fenofun/Powder-Trickler-Tank/images/Internal1.jpg

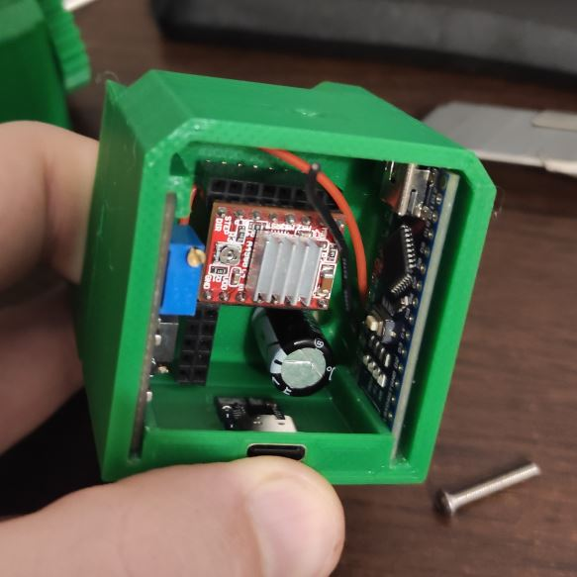
images/Internal1.jpg
