fenofun/Powder-Trickler-Tank/images/Driver1.jpg

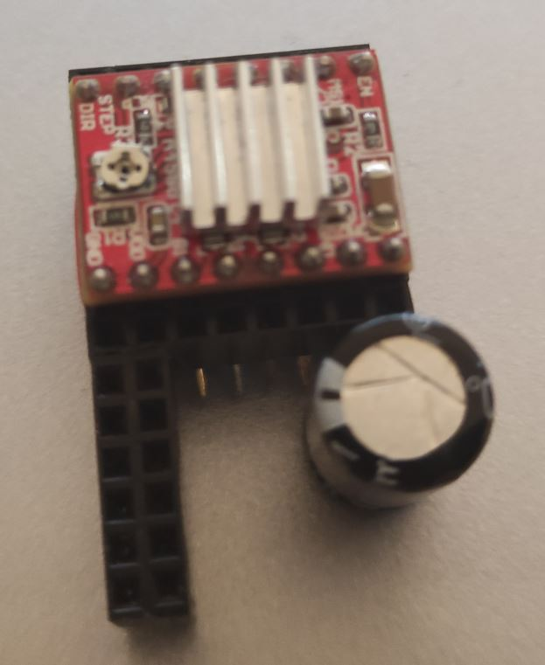
images/Driver1.jpg
