fenofun/Powder-Trickler-Tank/images/Driver2.jpg

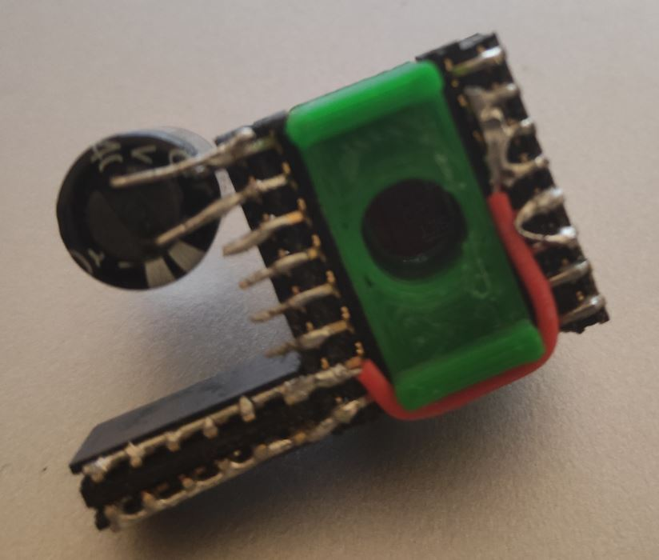
images/Driver2.jpg
