fenofun/Powder-Trickler-Tank/images/Internal2.jpg

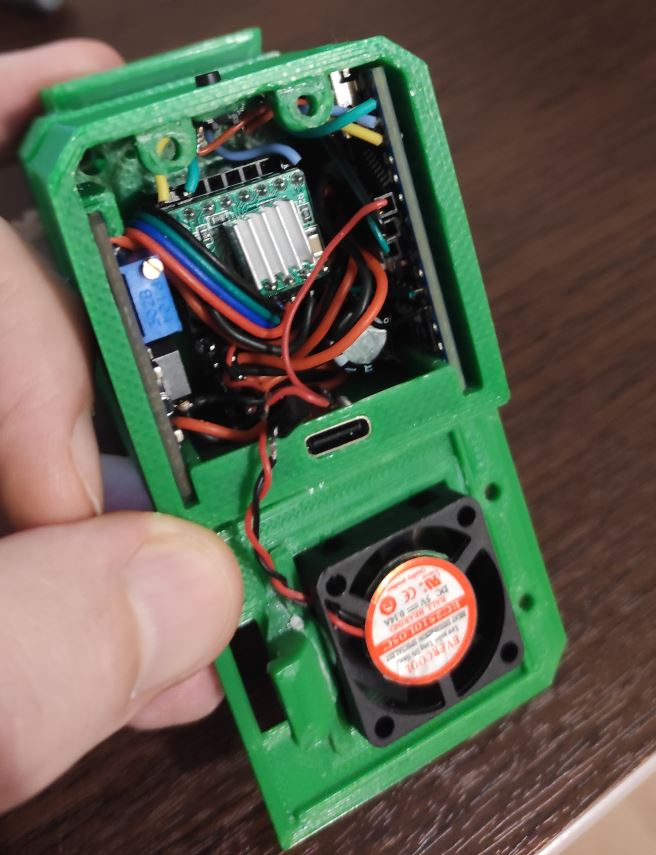
images/Internal2.jpg
