fenofun/Powder-Trickler-Tank/images/Scales.jpg

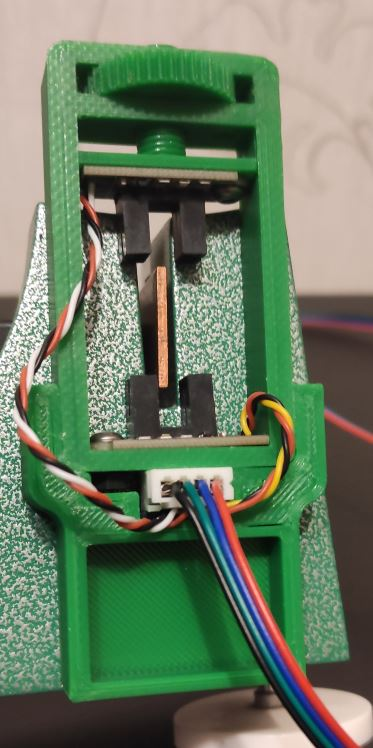
images/Scales.jpg
