fenofun/Powder-Trickler-Tank/images/TT_back.jpg

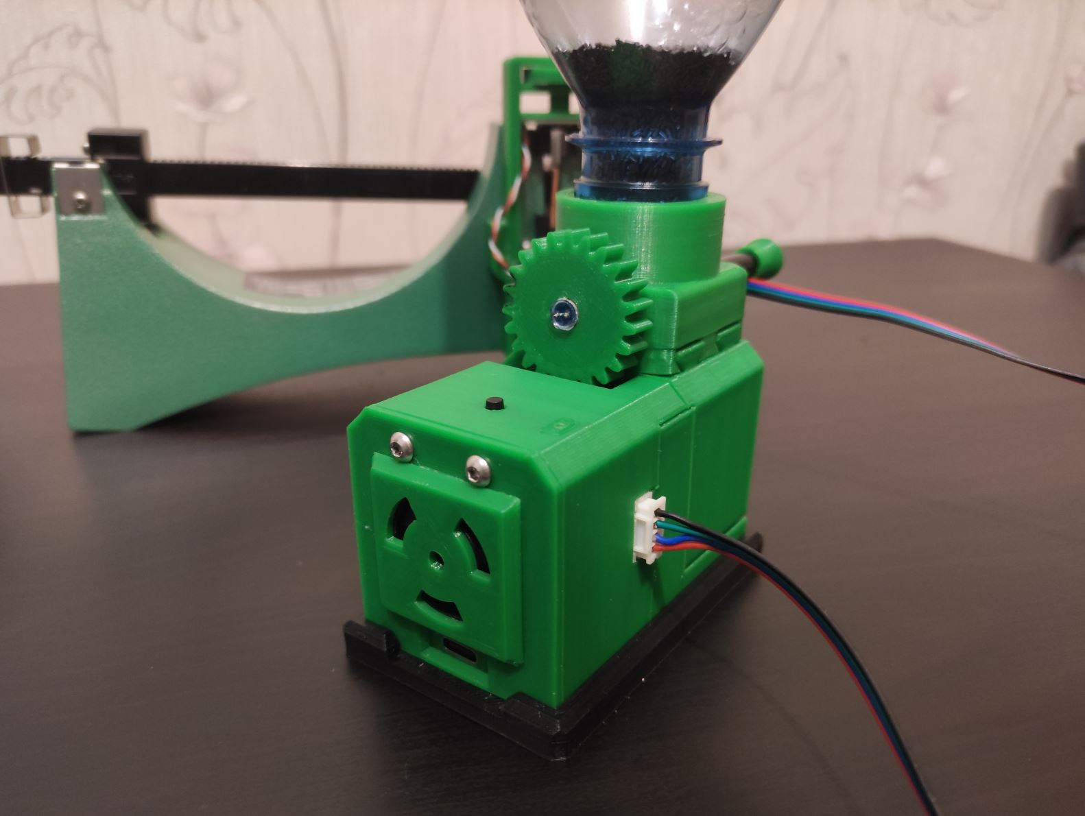
images/TT_back.jpg
