fenofun/Powder-Trickler-Tank/images/TT_front.jpg

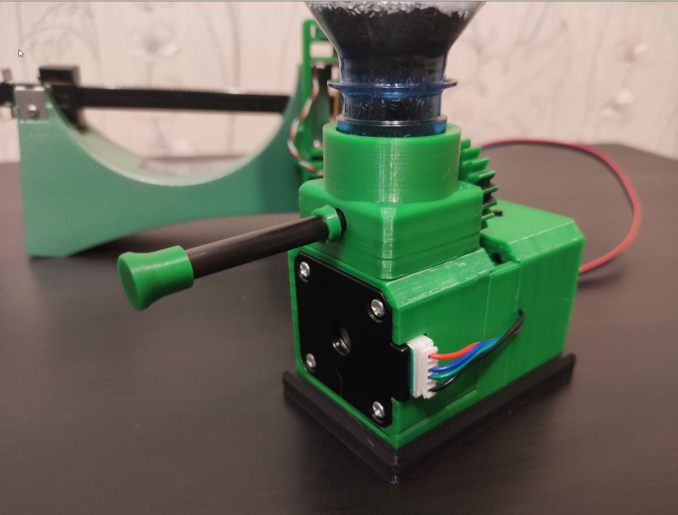
images/TT_front.jpg
