fenofun/Powder-Trickler-Tank/Scheme/Scheme.png

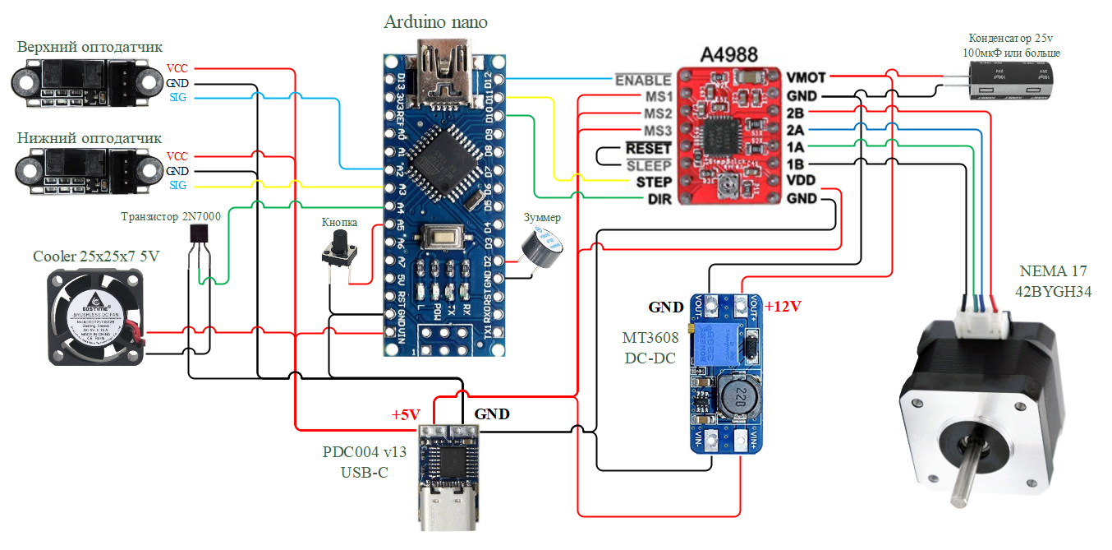
Scheme/Scheme.png
